losientowilson67/PCBRooting/Shield Arduino Mega 2025 v2/MachineJDG2025_MEGA2560_Shield_v2/fabrication/MachineJDG2025_MEGA2560_Shield_v2_schema.pdf

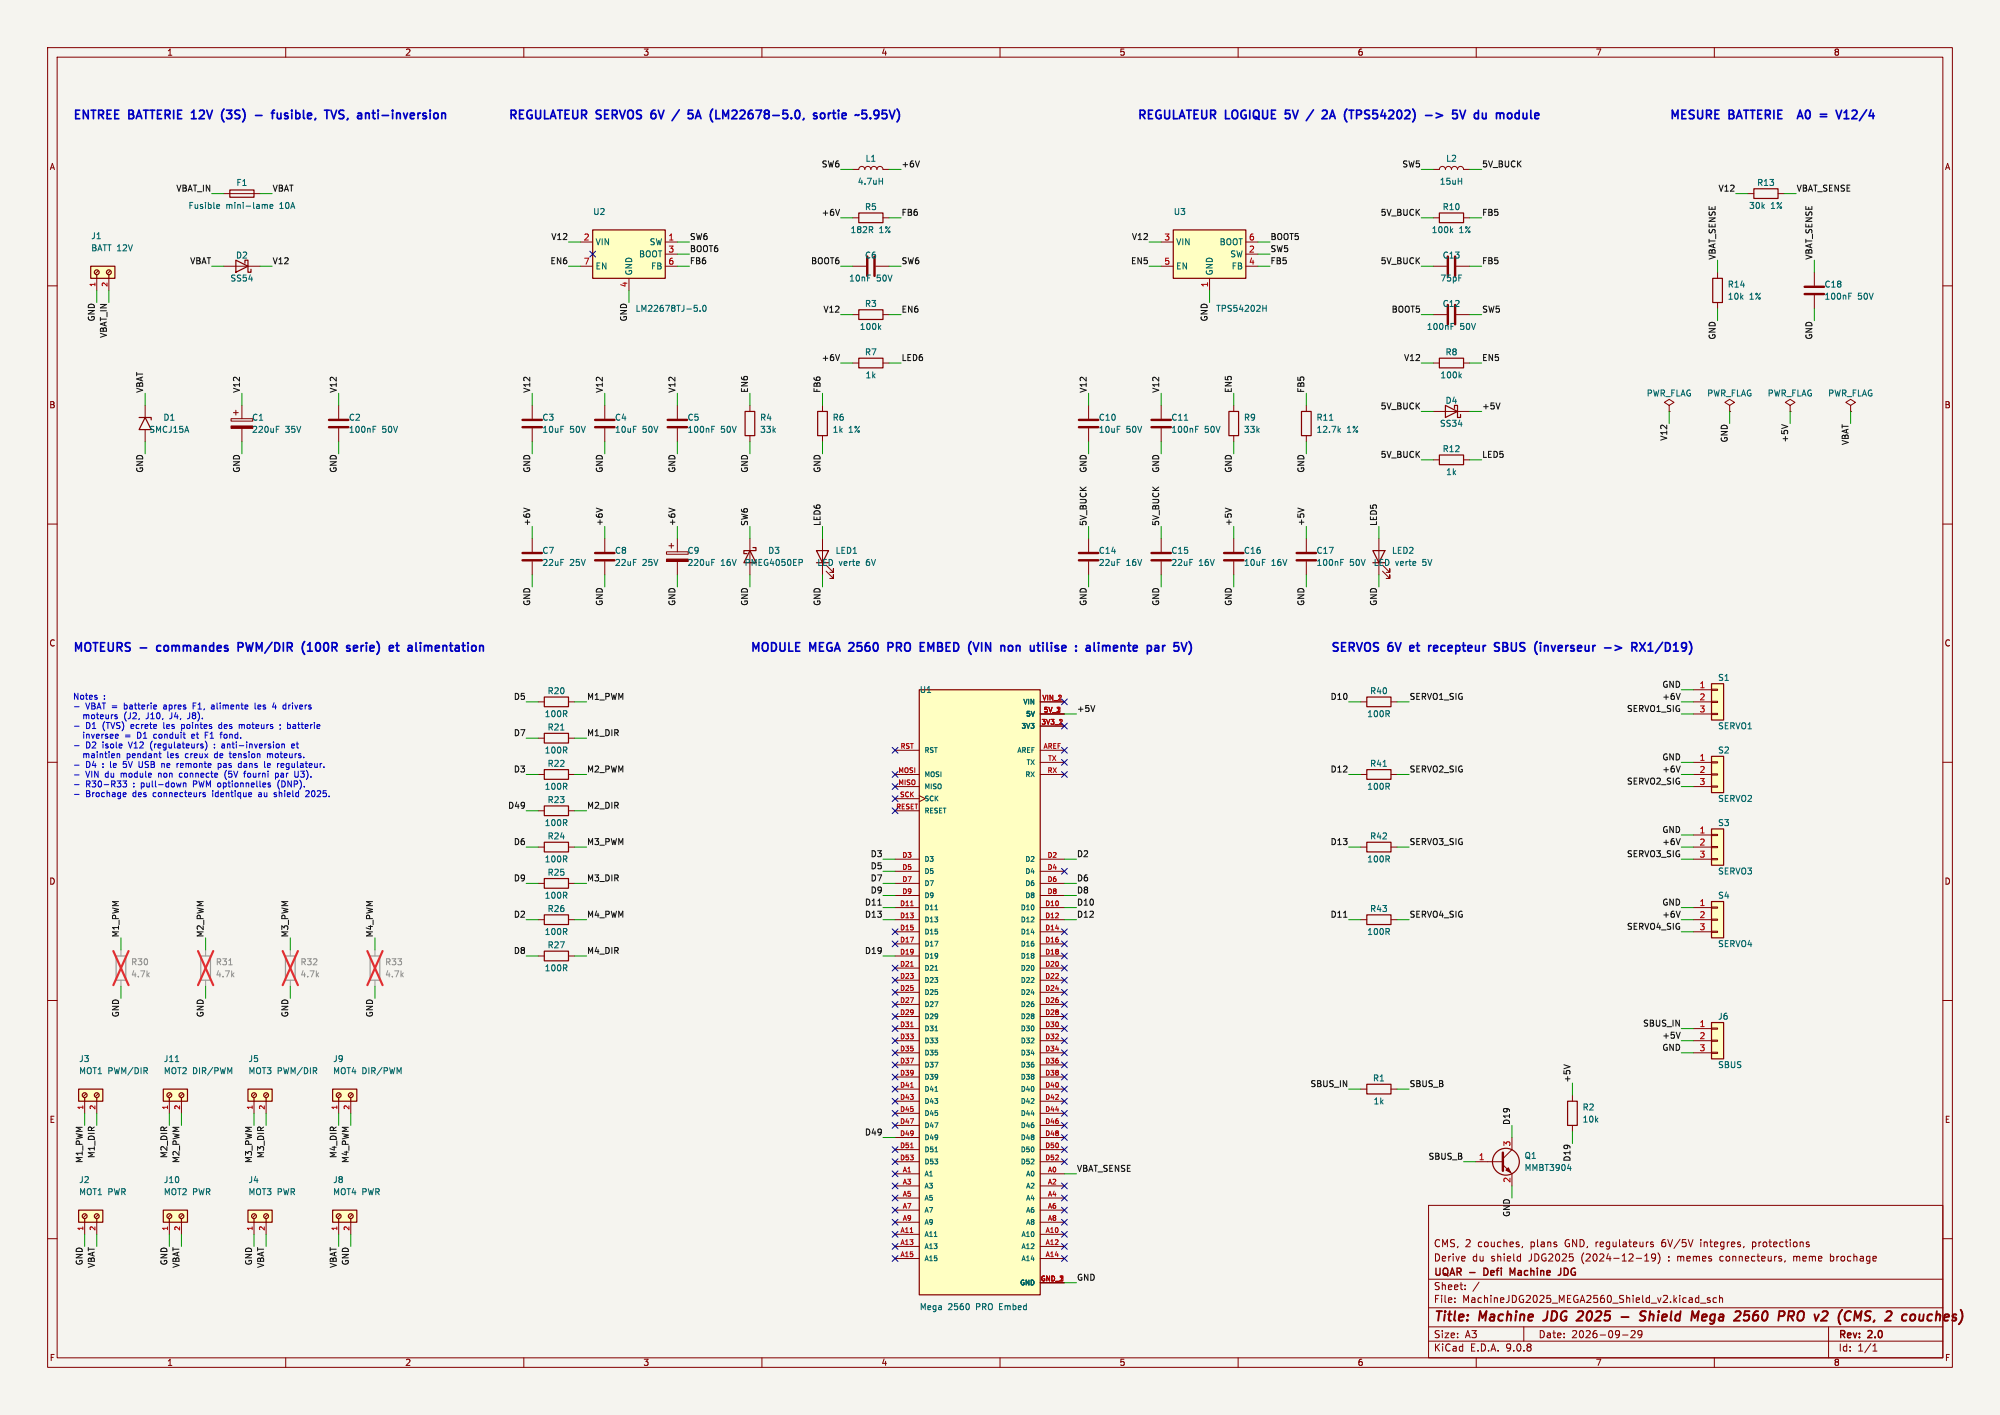
[picture p3: page 1]

ENTREE BATTERIE 12V (3S) - fusible, TVS, anti-inversion

MOTEURS - commandes PWM/DIR (100R serie) et alimentation
