losientowilson67/PCBRooting/Shield Arduino Mega 2025 v2/MachineJDG2025_MEGA2560_Shield_v2/fabrication/MachineJDG2025_MEGA2560_Shield_v2_dessus.pdf

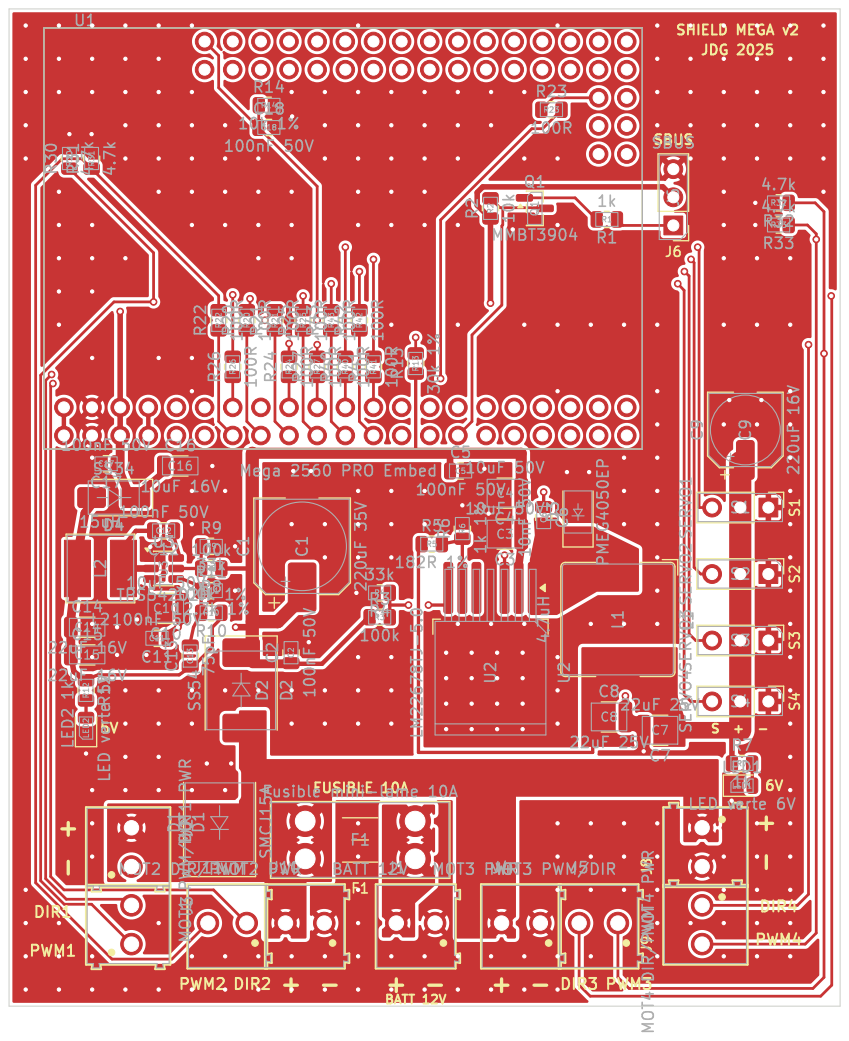
[picture p4: page 1]
