losientowilson67/PCBRooting/Shield Arduino Mega 2025 v2/MachineJDG2025_MEGA2560_Shield_v2/MachineJDG2025_MEGA2560_Shield_v2.kicad_pcb

## KiCad design Shield Arduino Mega 2025 v2/MachineJDG2025_MEGA2560_Shield_v2/MachineJDG2025_MEGA2560_Shield_v2.kicad_pcb (2026-09-30)

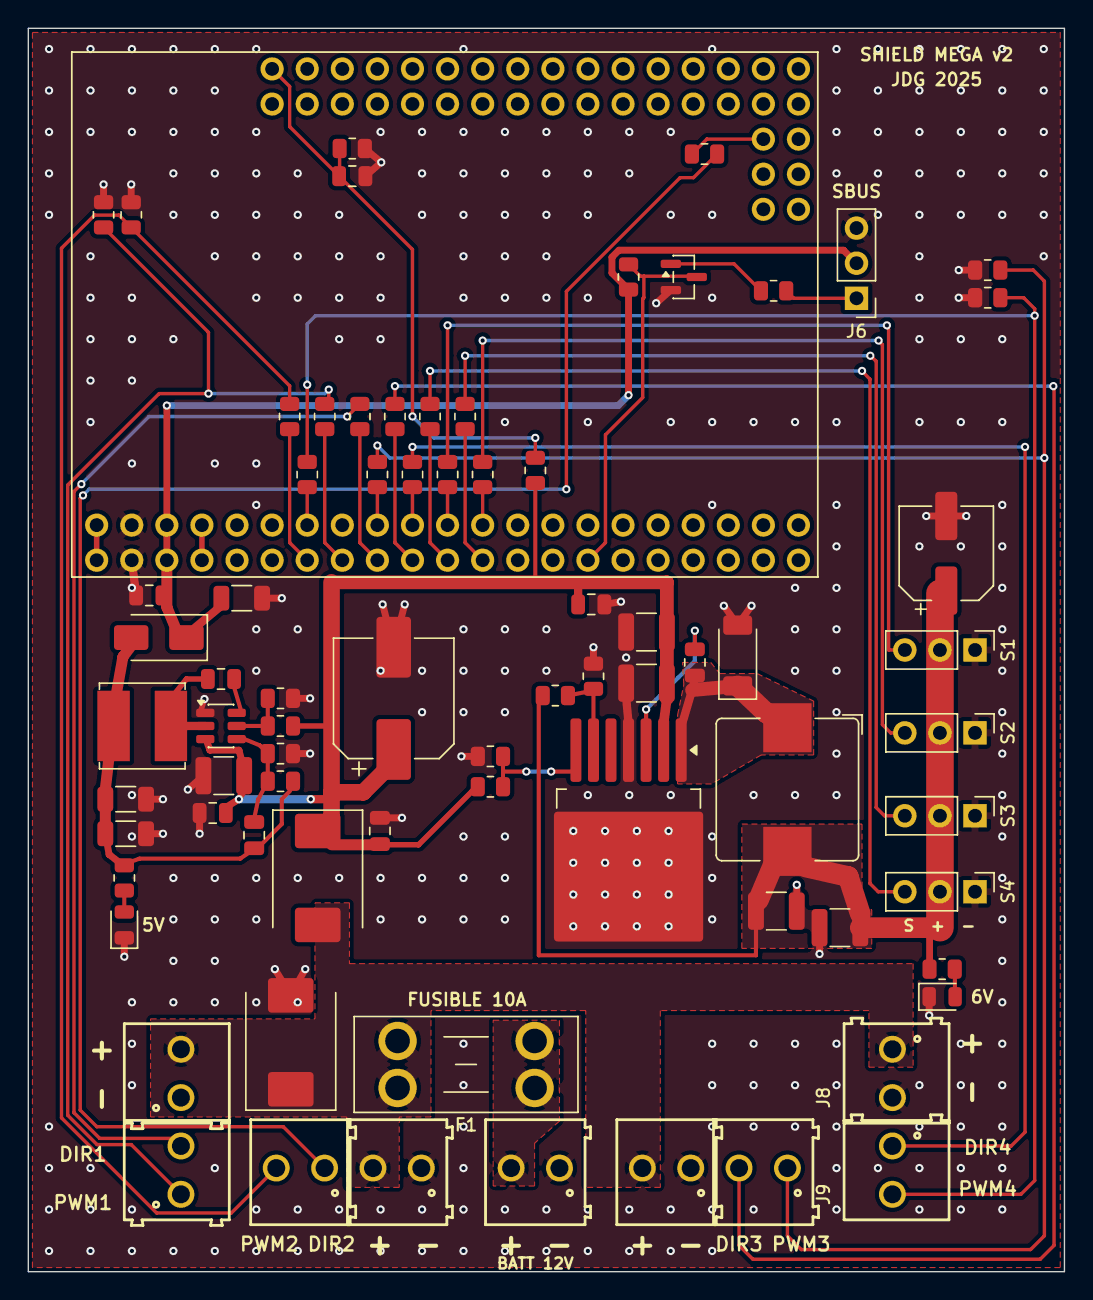
[picture p5: board MachineJDG2025_MEGA2560_Shield_v2.kicad_pcb from above]

Board: 2 copper layers, 75.0 x 90.0 mm, 75 parts (0 on the bottom side), 45 nets.

Parts:
C1: 220uF 35V; CP_Elec_8x10.5
C2, C5, C11, C12, C17, C18: 100nF 50V; C_0805_2012Metric
C3, C4, C10: 10uF 50V; C_1210_3225Metric
C6: 10nF 50V; C_0805_2012Metric
C7, C8: 22uF 25V; C_1210_3225Metric
C9: 220uF 16V; CP_Elec_6.3x7.7
C13: 75pF; C_0805_2012Metric
C14, C15: 22uF 16V; C_1206_3216Metric
C16: 10uF 16V; C_1206_3216Metric
D1: SMCJ15A; D_SMC
D2: SS54; D_SMC
D3: PMEG4050EP; D_SOD-128
D4: SS34; D_SMA
F1: Fusible mini-lame 10A; Fuseholder_Blade_Mini_Keystone_3568
J1: BATT 12V; 691214110002
J2: MOT1 PWR; 691214110002
J3: MOT1 PWM/DIR; 691214110002
J4: MOT3 PWR; 691214110002
J5: MOT3 PWM/DIR; 691214110002
J6: SBUS; PinHeader_1x03_P2.54mm_Vertical
J8: MOT4 PWR; 691214110002
J9: MOT4 DIR/PWM; 691214110002
J10: MOT2 PWR; 691214110002
J11: MOT2 DIR/PWM; 691214110002
L1: 4.7uH; L_Bourns_SRP1038C_10.0x10.0mm
L2: 15uH; L_Bourns_SRN6045TA
LED1: LED verte 6V; LED_0805_2012Metric
LED2: LED verte 5V; LED_0805_2012Metric
Q1: MMBT3904; SOT-23
R1, R7, R12: 1k; R_0805_2012Metric
R2: 10k; R_0805_2012Metric
R3, R8: 100k; R_0805_2012Metric
R4, R9: 33k; R_0805_2012Metric
R5: 182R 1%; R_0805_2012Metric
R6: 1k 1%; R_0805_2012Metric
R10: 100k 1%; R_0805_2012Metric
R11: 12.7k 1%; R_0805_2012Metric
R13: 30k 1%; R_0805_2012Metric
R14: 10k 1%; R_0805_2012Metric
R20, R21, R22, R23, R24, R25, R26, R27, R40, R41, R42, R43: 100R; R_0805_2012Metric
R30, R31, R32, R33: 4.7k; R_0805_2012Metric
S1: SERVO1; PinHeader_1x03_P2.54mm_Vertical
S2: SERVO2; PinHeader_1x03_P2.54mm_Vertical
S3: SERVO3; PinHeader_1x03_P2.54mm_Vertical
S4: SERVO4; PinHeader_1x03_P2.54mm_Vertical
U1: Mega 2560 PRO Embed; MODULE_MEGA_PRO_EMBED_CH340G_ATMEGA2560
U2: LM22678TJ-5.0; TO-263-7_TabPin8
U3: TPS54202H; SOT-23-6

Connections:
/5V_BUCK: C13.1, C14.1, C15.1, D4.2, L2.2, R10.1, R12.1
/+5V: C16.1, C17.1, D4.1, J6.2, R2.1, U1.5V_1, U1.5V_2
/+6V: C7.1, C8.1, C9.1, L1.2, R5.1, R7.1, S1.2, S2.2, S3.2, S4.2
/BOOT5: C12.1, U3.6
/BOOT6: C6.1, U2.3
/D2: R26.1, U1.D2
/D3: R22.1, U1.D3
/D5: R20.1, U1.D5
/D6: R24.1, U1.D6
/D7: R21.1, U1.D7
/D8: R27.1, U1.D8
/D9: R25.1, U1.D9
/D10: R40.1, U1.D10
/D11: R43.1, U1.D11
/D12: R41.1, U1.D12
/D13: R42.1, U1.D13
/D19: Q1.3, R2.2, U1.D19
/D49: R23.1, U1.D49
/EN5: R8.2, R9.1, U3.5
/EN6: R3.2, R4.1, U2.7
/FB5: C13.2, R10.2, R11.1, U3.4
/FB6: R5.2, R6.1, U2.6
/GND: C1.2, C2.2, C3.2, C4.2, C5.2, C7.2, C8.2, C9.2, C10.2, C11.2, C14.2, C15.2, C16.2, C17.2, C18.2, D1.2, D3.2, J1.1, J2.1, J4.1, J6.3, J8.2, J10.1, LED1.1, LED2.1, Q1.2, R4.2, R6.2, R9.2, R11.2, R14.2, R30.2, R31.2, R32.2, R33.2, S1.1, S2.1, S3.1, S4.1, U1.GND_1, U1.GND_2, U2.4, U2.8, U3.1
/LED5: LED2.2, R12.2
/LED6: LED1.2, R7.2
/M1_DIR: J3.2, R21.2
/M1_PWM: J3.1, R20.2, R30.1
/M2_DIR: J11.1, R23.2
/M2_PWM: J11.2, R22.2, R31.1
/M3_DIR: J5.2, R25.2
/M3_PWM: J5.1, R24.2, R32.1
/M4_DIR: J9.1, R27.2
/M4_PWM: J9.2, R26.2, R33.1
/SBUS_B: Q1.1, R1.2
/SBUS_IN: J6.1, R1.1
/SERVO1_SIG: R40.2, S1.3
/SERVO2_SIG: R41.2, S2.3
/SERVO3_SIG: R42.2, S3.3
/SERVO4_SIG: R43.2, S4.3
/SW5: C12.2, L2.1, U3.2
/SW6: C6.2, D3.1, L1.1, U2.1
/V12: C1.1, C2.1, C3.1, C4.1, C5.1, C10.1, C11.1, D2.1, R3.1, R8.1, R13.1, U2.2, U3.3
/VBAT: D1.1, D2.2, F1.2, J2.2, J4.2, J8.1, J10.2
/VBAT_IN: F1.1, J1.2
/VBAT_SENSE: C18.1, R13.2, R14.1, U1.A0
