losientowilson67/PCBRooting/Shield Arduino Mega 2025/MachineJDG2025_MEGA2560_Shield_VL_2024_12_19/MachineJDG2025_MEGA2560_Shield_VL_2024_12_19.kicad_pcb

## KiCad design Shield Arduino Mega 2025/MachineJDG2025_MEGA2560_Shield_VL_2024_12_19/MachineJDG2025_MEGA2560_Shield_VL_2024_12_19.kicad_pcb (2026-09-29, an earlier design)

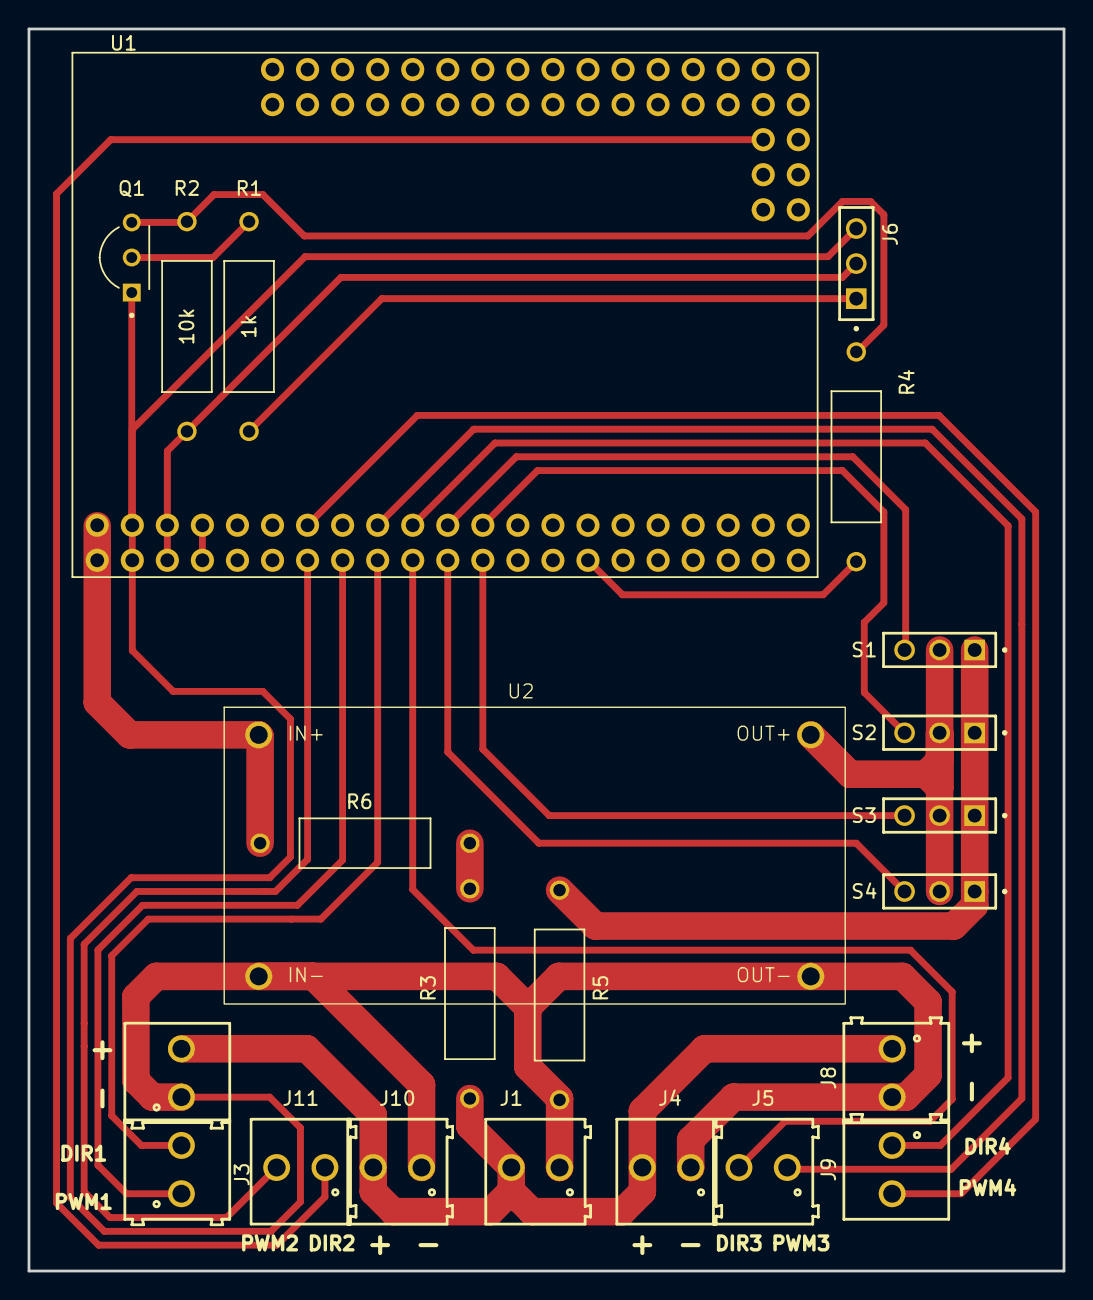
[picture p6: board MachineJDG2025_MEGA2560_Shield_VL_2024_12_19.kicad_pcb from above]

Board: 2 copper layers, 75.0 x 90.0 mm, 23 parts (0 on the bottom side), 24 nets.

Parts:
J1, J2, J3, J4, J5, J8, J9, J10, J11: 691214110002
J6: SSW-103-01-F-D; SAMTEC_SSW-103-01-F-D_3X1
Q1: 2N2222A; TO92254P470H750-3
R1: 1k; RESAD1520W70L1030D380
R2: 10k; RESAD1520W70L1030D380
R3, R4, R5, R6: 0; RESAD1520W70L1030D380
S1, S2, S3, S4: SSW-103-01-F-D; SAMTEC_SSW-103-01-F-D_3X1
U1: MEGA_PRO_EMBED_CH340G___ATMEGA2560; MODULE_MEGA_PRO_EMBED_CH340G___ATMEGA2560
U2: LM2596; LM2956

Connections:
3V3: U1.3V3_1 (3V3), U1.3V3_2 (3V3)
5V: J6.02, R2.1, U1.5V_1 (5V), U1.5V_2 (5V)
6V: S1.02, S2.02, S3.02, S4.02, U2.3 (Vout+)
12V: R6.1, U1.VIN_1 (VIN), U1.VIN_2 (VIN), U2.1 (Vin+)
D2: J9.2, U1.D2
D3: J11.2, U1.D3
D5: J3.1, U1.D5
D6: J5.1, U1.D6
D7: J3.2, U1.D7
D8: J9.1, U1.D8
D9: J5.2, U1.D9
D10: S1.03, U1.D10
D11: S4.03, U1.D11
D12: S2.03, U1.D12
D13: S3.03, U1.D13
D19: R4.2, U1.D19
D49: J11.1, U1.D49
GND: J1.1, J2.1, J4.1, J6.03, J8.2, J10.1, Q1.1, R5.2, U1.GND_1 (GND), U1.GND_2 (GND), U2.2 (Vin-), U2.4 (Vout-)
unnamed: J1.2, J2.2, J4.2, J8.1, J10.2, R3.2
unnamed: Q1.2, R1.2
unnamed: Q1.3, R2.2, R4.1
unnamed: R3.1, R6.2
unnamed: R5.1, S1.01, S2.01, S3.01, S4.01
S_BUS: J6.01, R1.1
