losientowilson67/PCBRooting/MachineJDG2027_Shield_v2/MachineJDG2027_Shield_v2.kicad_pcb

## KiCad design MachineJDG2027_Shield_v2/MachineJDG2027_Shield_v2.kicad_pcb (2026-09-29)

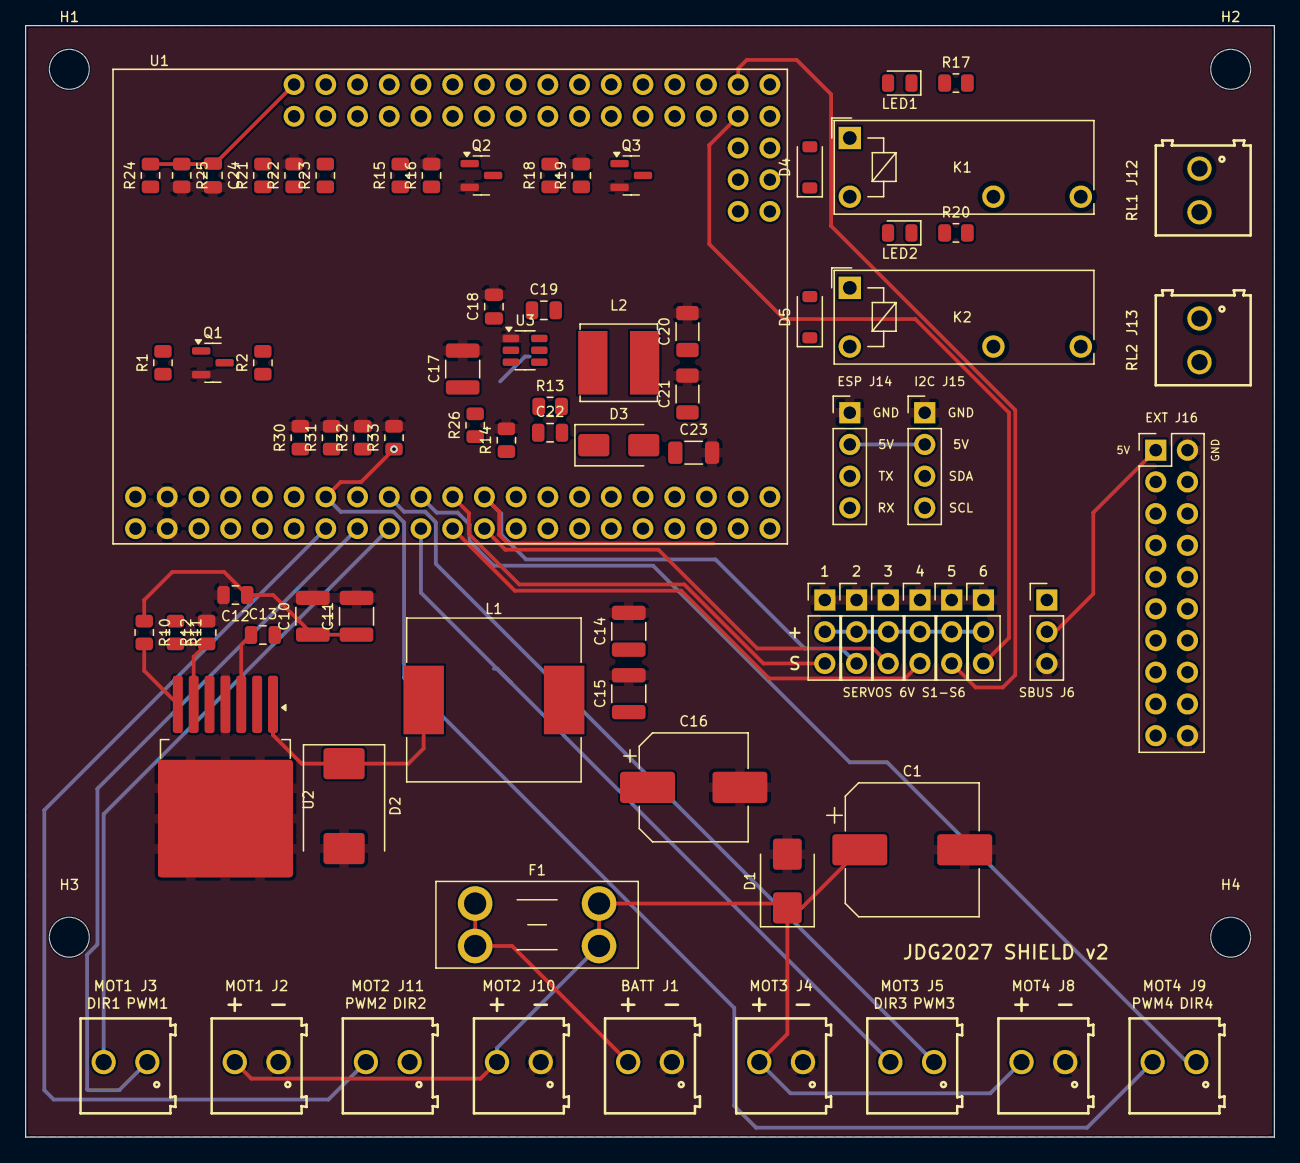
[picture p7: board MachineJDG2027_Shield_v2.kicad_pcb from above]

Board: 2 copper layers, 100.0 x 89.0 mm, 82 parts (0 on the bottom side), 66 nets.

Parts:
C1: 470uF 25V; CP_Elec_10x10.5
C10, C11, C17: 10uF 50V; C_1210_3225Metric
C12: 1uF 50V; C_0805_2012Metric
C13: 10nF 50V; C_0805_2012Metric
C14, C15: 22uF 25V; C_1210_3225Metric
C16: 220uF 16V; CP_Elec_8x10.5
C18, C19, C24: 100nF; C_0805_2012Metric
C20, C21: 22uF 16V; C_1206_3216Metric
C22: 75pF; C_0805_2012Metric
C23: 10uF 16V; C_1206_3216Metric
D1: SMBJ15A; D_SMB
D2: SS54; D_SMC
D3: SS34; D_SMA
D4, D5: 1N4148W; D_SOD-123
F1: 10A mini-lame; Fuseholder_Blade_Mini_Keystone_3568
H1, H2, H3, H4: M3; MountingHole_3.2mm_M3
J1: BATT_IN; 691214110002
J2: MOT_PWR1; 691214110002
J3: MOT1 PWM/DIR; 691214110002
J4: MOT_PWR3; 691214110002
J5: MOT3 PWM/DIR; 691214110002
J6: SBUS; PinHeader_1x03_P2.54mm_Vertical
J8: MOT_PWR4; 691214110002
J9: MOT4 DIR/PWM; 691214110002
J10: MOT_PWR2; 691214110002
J11: MOT2 DIR/PWM; 691214110002
J12: RELAIS1; 691214110002
J13: RELAIS2; 691214110002
J14: UART2_ESP; PinHeader_1x04_P2.54mm_Vertical
J15: I2C; PinHeader_1x04_P2.54mm_Vertical
J16: EXT_IO; PinHeader_2x10_P2.54mm_Vertical
K1, K2: G5NB-1A-E DC5V; Relay_SPST_Omron_G5NB
L1: 4.7uH; L_Sunlord_MWSA1265S
L2: 15uH; L_Bourns_SRN6045TA
LED1, LED2: LED verte; LED_0805_2012Metric
Q1: MMBT3904; SOT-23
Q2, Q3: 2N7002; SOT-23
R1, R17, R20, R21, R23: 1k; R_0805_2012Metric
R2, R16, R19: 10k; R_0805_2012Metric
R10: 470k; R_0805_2012Metric
R11: 182R 1%; R_0805_2012Metric
R12: 1k 1%; R_0805_2012Metric
R13: 100k 1%; R_0805_2012Metric
R14: 12.7k 1%; R_0805_2012Metric
R15, R18: 100R; R_0805_2012Metric
R22: 2k; R_0805_2012Metric
R24: 30k 1%; R_0805_2012Metric
R25: 10k 1%; R_0805_2012Metric
R26: 510k; R_0805_2012Metric
R30, R31, R32, R33: 4.7k DNP; R_0805_2012Metric
S1: SERVO1; PinHeader_1x03_P2.54mm_Vertical
S2: SERVO2; PinHeader_1x03_P2.54mm_Vertical
S3: SERVO3; PinHeader_1x03_P2.54mm_Vertical
S4: SERVO4; PinHeader_1x03_P2.54mm_Vertical
S5: SERVO5; PinHeader_1x03_P2.54mm_Vertical
S6: SERVO6; PinHeader_1x03_P2.54mm_Vertical
U1: Mega2560 PRO Embed; MODULE_MEGA_PRO_EMBED_CH340G_ATMEGA2560
U2: LM22678TJ-5.0; TO-263-7_TabPin8
U3: TPS54202H; SOT-23-6

Connections:
+5V: C23.1, D3.1, D4.1, D5.1, J6.2, J14.2, J15.2, J16.1, J16.19, K1.A1, K2.A1, R2.1, R17.1, R20.1, U1.5V_1, U1.5V_2
+5V_BUCK: C20.1, C21.1, C22.1, D3.2, L2.2, R13.1
+6V: C14.1, C15.1, C16.1, L1.2, R11.1, S1.2, S2.2, S3.2, S4.2, S5.2, S6.2
A0: C24.1, R24.2, R25.1, U1.A0
A1: J16.3, U1.A1
A2: J16.4, U1.A2
A3: J16.5, U1.A3
A4: J16.6, U1.A4
A5: J16.7, U1.A5
A6: J16.8, U1.A6
A7: J16.9, U1.A7
BOOT5: C19.1, U3.6
BOOT6: C13.1, U2.3
D2: J9.2, R33.1, U1.D2
D3: J11.2, R31.1, U1.D3
D5: J3.1, R30.1, U1.D5
D6: J5.1, R32.1, U1.D6
D7: J3.2, U1.D7
D8: J9.1, U1.D8
D9: J5.2, U1.D9
D10: S1.3, U1.D10
D11: S4.3, U1.D11
D12: S2.3, U1.D12
D13: S3.3, U1.D13
D16: R21.1, U1.D16
D17: R23.2, U1.D17
D19: Q1.3, R2.2, U1.D19
D20: J15.3, U1.D20
D21: J15.4, U1.D21
D22: R15.1, U1.D22
D23: R18.1, U1.D23
D24: J16.10, U1.D24
D25: J16.11, U1.D25
D26: J16.12, U1.D26
D27: J16.13, U1.D27
D28: J16.14, U1.D28
D29: J16.15, U1.D29
D30: J16.16, U1.D30
D31: J16.17, U1.D31
D32: J16.18, U1.D32
D44: S5.3, U1.D44
D45: S6.3, U1.D45
D49: J11.1, U1.D49
EN5: R26.2, U3.5
EN6: R10.2, U2.7
ESP_RX: J14.3, R21.2, R22.1
ESP_TX: J14.4, R23.1
FB5: C22.2, R13.2, R14.1, U3.4
FB6: R11.2, R12.1, U2.6
GND: C1.2, C10.2, C11.2, C12.2, C14.2, C15.2, C16.2, C17.2, C18.2, C20.2, C21.2, C23.2, C24.2, D1.2, D2.2, J1.1, J2.1, J4.1, J6.3, J8.1, J10.1, J14.1, J15.1, J16.2, J16.20, Q1.2, Q2.2, Q3.2, R12.2, R14.2, R16.2, R19.2, R22.2, R25.2, R30.2, R31.2, R32.2, R33.2, S1.1, S2.1, S3.1, S4.1, S5.1, S6.1, U1.GND_1, U1.GND_2, U2.4, U2.8, U3.1
K1_DRV: D4.2, K1.A2, LED1.1, Q2.3
K1_G: Q2.1, R15.2, R16.1
K1_LED: LED1.2, R17.2
K2_DRV: D5.2, K2.A2, LED2.1, Q3.3
K2_G: Q3.1, R18.2, R19.1
K2_LED: LED2.2, R20.2
RL1_A: J12.1, K1.13
RL1_B: J12.2, K1.14
RL2_A: J13.1, K2.13
RL2_B: J13.2, K2.14
SBUS_B: Q1.1, R1.2
SW5: C19.2, L2.1, U3.2
SW6: C13.2, D2.1, L1.1, U2.1
S_BUS: J6.1, R1.1
VBAT: C1.1, C10.1, C11.1, C12.1, C17.1, C18.1, D1.1, F1.2, J2.2, J4.2, J8.2, J10.2, R10.1, R24.1, R26.1, U2.2, U3.3
VBAT_IN: F1.1, J1.2
