losientowilson67/PCBRooting/Shield Arduino Mega 2025 v2/outils/route.py

# Routage manuel : alimentations, regulateurs, vias de masse, zones et keepouts.
# (net, couche 'F'/'B', largeur mm, [points])
T = []
V = []          # (net, x, y) vias 0.6/0.3
VBIG = []       # (net, x, y) vias 0.8/0.4 (courant)


def t(net, lay, w, *pts):
    T.append((net, lay, w, list(pts)))


def v(net, x, y):
    V.append((net, x, y))


# ---------------- V12 (apres D2) ----------------
t("V12", "F", 1.2, (206.5, 100.6), (207.5, 99.6), (207.5, 82.6))          # D2 K -> montee
t("V12", "F", 1.0, (207.5, 82.6), (231.775, 82.6), (231.775, 91.0))        # bus -> C4/C3
t("V12", "F", 0.7, (231.775, 91.0), (231.54, 92.8))                        # -> VIN U2
t("V12", "F", 1.2, (207.5, 97.8), (209.8, 97.8), (212.0, 95.6))            # -> C1 +
t("V12", "F", 0.8, (207.5, 101.6), (211.0, 101.6))                         # -> C2
t("V12", "F", 0.4, (211.0, 101.6), (213.8, 101.6), (217.7, 97.7), (218.088, 97.4))  # -> R3
t("V12", "F", 0.4, (207.5, 93.0), (204.712, 93.0))                         # -> R8
t("V12", "F", 0.6, (225.35, 82.6), (225.35, 83.7))                         # -> C5
t("V12", "F", 0.3, (222.25, 82.6), (222.25, 75.4))                         # -> R13 (sous module)
# saut B.Cu vers le regulateur 5V (croise FB5)
t("V12", "F", 0.6, (207.5, 98.3), (206.0, 98.3))
v("V12", 206.0, 98.3)
t("V12", "B", 0.6, (206.0, 98.3), (200.8, 98.3))
v("V12", 200.8, 98.3)
t("V12", "F", 0.5, (200.8, 98.3), (201.175, 97.6))                         # -> C10
t("V12", "F", 0.5, (200.8, 98.3), (200.0, 98.8))                           # -> C11
t("V12", "F", 0.5, (201.0, 95.5), (200.8, 94.75), (198.7, 94.75), (198.5, 94.2))  # C10 -> VIN U3

# ---------------- regulateur 6V ----------------
t("EN6", "F", 0.3, (219.912, 95.2), (219.912, 97.4))
t("EN6", "F", 0.3, (219.912, 96.3), (221.6, 96.3))
v("EN6", 221.6, 96.3)
t("EN6", "B", 0.3, (221.6, 96.3), (223.4, 96.3))
v("EN6", 223.4, 96.3)
t("EN6", "F", 0.3, (223.4, 96.3), (224.9, 96.3))
t("FB6", "F", 0.3, (224.613, 90.8), (226.1, 90.5))
t("FB6", "F", 0.3, (226.46, 90.3), (226.46, 92.8))
t("+6V", "F", 0.3, (238.225, 107.4), (238.225, 109.6), (222.5, 109.6), (222.5, 91.4))  # retour tension
t("BOOT6", "F", 0.3, (230.27, 92.8), (230.27, 91.8))
v("BOOT6", 230.27, 91.8)
t("BOOT6", "B", 0.3, (230.27, 91.8), (232.6, 89.5), (233.8, 88.3), (233.8, 86.1))
v("BOOT6", 233.8, 86.1)
t("BOOT6", "F", 0.3, (233.8, 86.1), (233.8, 87.2))
t("GND", "F", 0.6, (229.0, 92.8), (228.85, 91.2))                           # pin 4 -> C3
t("SW6", "F", 0.6, (232.95, 92.6), (233.6, 90.4), (233.8, 89.6))
t("SW6", "F", 1.0, (233.6, 90.4), (236.9, 90.1))
t("SW6", "F", 1.5, (236.9, 90.1), (238.9, 92.0), (240.5, 93.1))
t("+6V", "F", 1.5, (239.5, 103.0), (238.4, 105.6))                          # L1 -> C8
t("+6V", "F", 1.5, (241.8, 103.2), (244.9, 103.9), (245.775, 106.6))        # L1 -> C7
t("+6V", "F", 1.5, (245.775, 107.6), (251.54, 107.6))                       # vers servos
t("+6V", "F", 2.0, (251.54, 107.6), (251.54, 83.4))                         # bus servos -> C9
t("+6V", "F", 0.5, (250.79, 107.6), (250.79, 110.2))                        # -> R7
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
# B.Cu autorise seulement dans une bande sous le module (croisements des signaux)
BKO2 = [[(185.6, 42.55), (260.5, 42.55), (260.5, 64.0), (185.6, 64.0)],
        [(185.6, 77.6), (260.5, 77.6), (260.5, 132.45), (185.6, 132.45)],
        [(185.6, 64.0), (188.3, 64.0), (188.3, 77.6), (185.6, 77.6)]]
