losientowilson67/PCBRooting/Shield Arduino Mega 2025 v2/outils/place.py

# Placement des empreintes (x, y, rotation) en mm, coordonnees absolues KiCad.
# Contour identique au shield 2025 : x 185.553..260.553, y 42.5..132.5
BX0, BY0, BX1, BY1 = 185.553, 42.5, 260.553, 132.5

PL = {
    # --- fixes : memes positions que le shield 2025 ---
    "U1": (215.7, 63.22, 0),
    "J1": (222.25, 125.0, 180),
    "J2": (196.6, 118.15, 90),
    "J3": (196.6, 125.15, 90),
    "J4": (231.75, 125.0, 180),
    "J5": (238.75, 125.0, 180),
    "J8": (248.1, 118.15, -90),
    "J9": (248.1, 125.15, -90),
    "J10": (212.25, 125.0, 180),
    "J11": (205.25, 125.0, 180),
    "J6": (245.5, 62.04, 180),
    "S1": (254.08, 87.5, -90),
    "S2": (254.08, 93.5, -90),
    "S3": (254.08, 99.5, -90),
    "S4": (254.08, 105.0, -90),

    # --- entree batterie ---
    "F1": (222.2, 119.2, 180),
    "D1": (204.55, 115.9, 90),
    "D2": (206.5, 104.0, -90),
    "C1": (212.0, 91.0, 90),
    "C2": (211.0, 100.6, 90),

    # --- regulateur 6V (milieu droite) ---
    "U2": (229.0, 102.4, -90),
    "L1": (240.5, 97.6, -90),
    "D3": (236.9, 87.9, 90),
    "C3": (230.3, 89.9, 180),
    "C4": (230.3, 86.2, 180),
    "C5": (226.3, 84.2, 0),
    "C6": (233.8, 88.4, -90),
    "R3": (219.0, 97.4, 0),
    "R4": (219.0, 95.2, 180),
    "R5": (223.7, 90.8, 0),
    "R6": (226.46, 89.4, 90),
    "C7": (244.3, 107.6, 180),
    "C8": (239.7, 106.4, 0),
    "C9": (252.0, 80.5, 90),
    "R7": (251.7, 110.6, 0),
    "LED1": (251.7, 112.6, 0),

    # --- regulateur 5V (milieu gauche) ---
    "U3": (199.5, 93.0, 0),
    "L2": (193.8, 93.0, 180),
    "C12": (199.5, 89.6, 180),
    "C10": (199.7, 96.6, 180),
    "C11": (198.9, 99.3, 180),
    "R8": (203.8, 93.0, 180),
    "R9": (203.8, 91.0, 0),
    "R11": (203.8, 95.0, 0),
    "R10": (203.8, 97.0, 180),
    "C13": (201.9, 100.9, 90),
    "C14": (192.6, 98.3, 0),
    "C15": (192.6, 100.8, 0),
    "D4": (195.0, 86.6, 180),
    "C16": (201.0, 83.75, 0),
    "C17": (194.31, 83.55, 180),
    "R12": (192.5, 104.0, -90),
    "LED2": (192.5, 107.4, 90),

    # --- mesure batterie : R13 depuis V12, R14/C18 pres de A0 ---
    "R13": (222.25, 74.5, 90),
    "R14": (209.0, 51.2, 0),
    "C18": (209.0, 53.2, 0),

    # --- resistances serie sous le module ---
    "R26": (205.74, 74.8, 90),   # D2  -> M4_PWM
    "R24": (210.82, 74.8, 90),   # D6  -> M3_PWM
    "R27": (213.36, 74.8, 90),   # D8  -> M4_DIR
    "R40": (215.9, 74.8, 90),    # D10 -> SERVO1
    "R41": (218.44, 74.8, 90),   # D12 -> SERVO2
    "R22": (204.47, 70.6, 90),   # D3  -> M2_PWM
    "R20": (207.01, 70.6, 90),   # D5  -> M1_PWM
    "R21": (209.55, 70.6, 90),   # D7  -> M1_DIR
    "R25": (212.09, 70.6, 90),   # D9  -> M3_DIR
    "R43": (214.63, 70.6, 90),   # D11 -> SERVO4
    "R42": (217.17, 70.6, 90),   # D13 -> SERVO3
    "R23": (234.5, 51.6, 0),     # D49 -> M2_DIR
    "R30": (191.0, 56.0, 90),
    "R31": (193.0, 56.0, 90),
    "R32": (255.0, 60.0, 180),
    "R33": (255.0, 62.0, 180),

    # --- SBUS ---
    "Q1": (233.0, 60.5, 0),
    "R1": (239.5, 61.5, 180),
    "R2": (229.0, 60.5, 90),
}
