losientowilson67/PCBRooting/(commit log)

2026-09-29 WIP shield Mega 2025 v2 : scripts de generation (schema, placement, routage)
    Sauvegarde de travail en cours : definition du circuit, placement et
    routage manuel des alimentations. Le PCB n'est pas encore route ni verifie.
    Claude-Session: https://claude.ai/code/session_01RkCWTUiw8rjutUV6gtwoAt
2026-09-29 WIP shield Mega 2025 v2 : definition du circuit et routage manuel
    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
2026-09-29 WIP shield Mega 2025 v2 : generateurs schema/PCB et exports
    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
2026-09-29 WIP shield Mega 2025 v2 : generateur de schema
    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
2026-09-29 Shield Mega 2025 v2 : PCB CMS 2 couches termine + fabrication
    - PCB route complet (plan GND dessous, remplissage GND dessus, 277 vias
    de couture, zones VBAT/6V), meme contour et connecteurs que le 2025
    - Parite schema/PCB : nets nommes comme le schema, broches NC, DNP alignes
    - Fabrication : Gerbers/percages JLCPCB, BOM + CPL JLC, PDF, rendus 3D
    - LISEZMOI du projet (changements, mise en garde, points a verifier)
    - Outils de generation synchronises (finition, renommage des nets,
    conversion JLC, scripts de chaine portables)
    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
    [BOM_JLCPCB.csv, BOM_complet.csv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]
